plerros/Haptic-Bracelet/freecad/auxiliary/auxiliary.FCStd

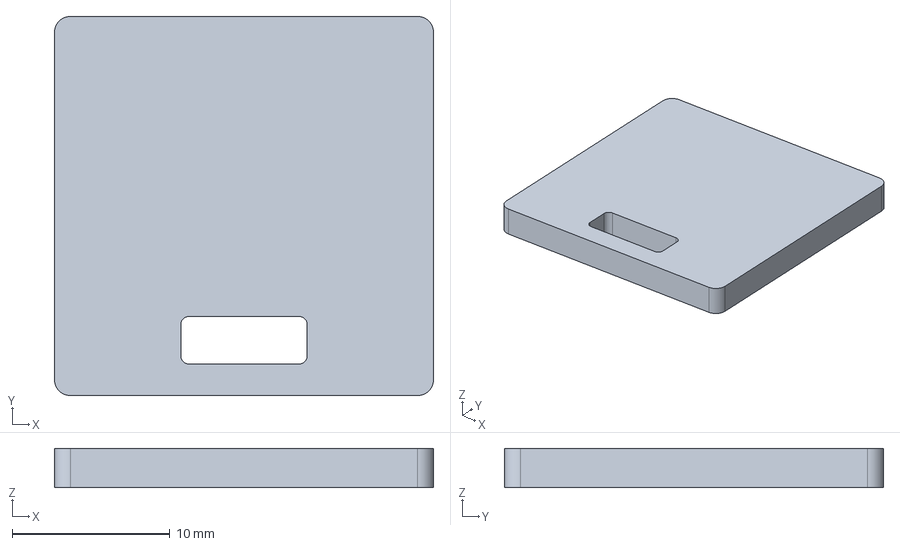
[picture p1: CAD file, 2025-09-05]
freecad/auxiliary/auxiliary.FCStd
24.0 x 24.0 x 2.50 mm
