plerros/Haptic-Bracelet/kicad/haptic-bracelet/haptic-bracelet.step

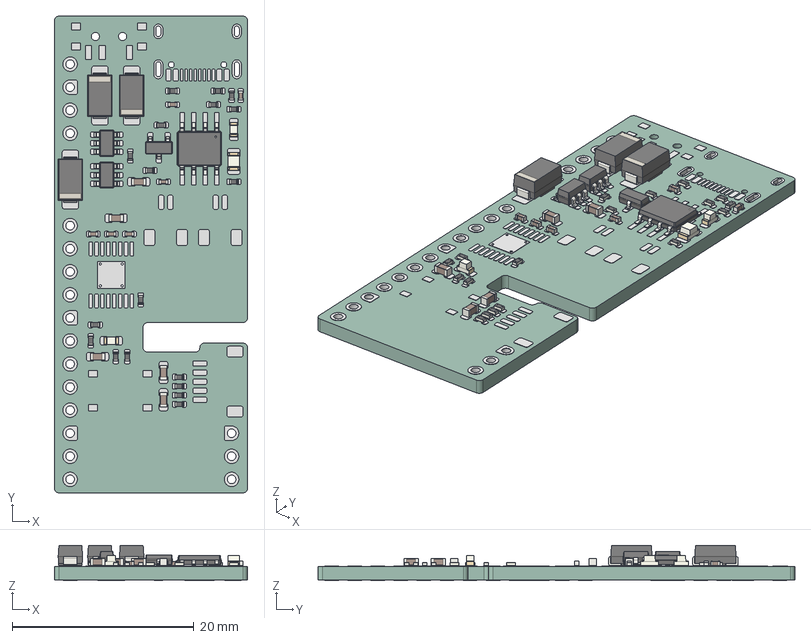
[picture p2: CAD file, 2025-09-05]
kicad/haptic-bracelet/haptic-bracelet.step
21.3 x 52.5 x 3.86 mm
SOT-23-6 x 2
R_0402_1005Metric x 18
C_0402_1005Metric x 6
C_0603_1608Metric x 5
D_SMA x 3
LED_0805_2012Metric
LED_0603_1608Metric x 2
SOT-23
Texas_HTSOP-8-1EP_3.9x4.9mm_P1.27mm_EP2.85x4.9mm_Mask2.4x3.1mm_ ThermalVias
haptic-bracelet_pad
haptic-bracelet_PCB
