plerros/Haptic-Bracelet/kicad/auxiliary/auxiliary.kicad_pcb

## KiCad design kicad/auxiliary/auxiliary.kicad_pcb (2025-09-05)

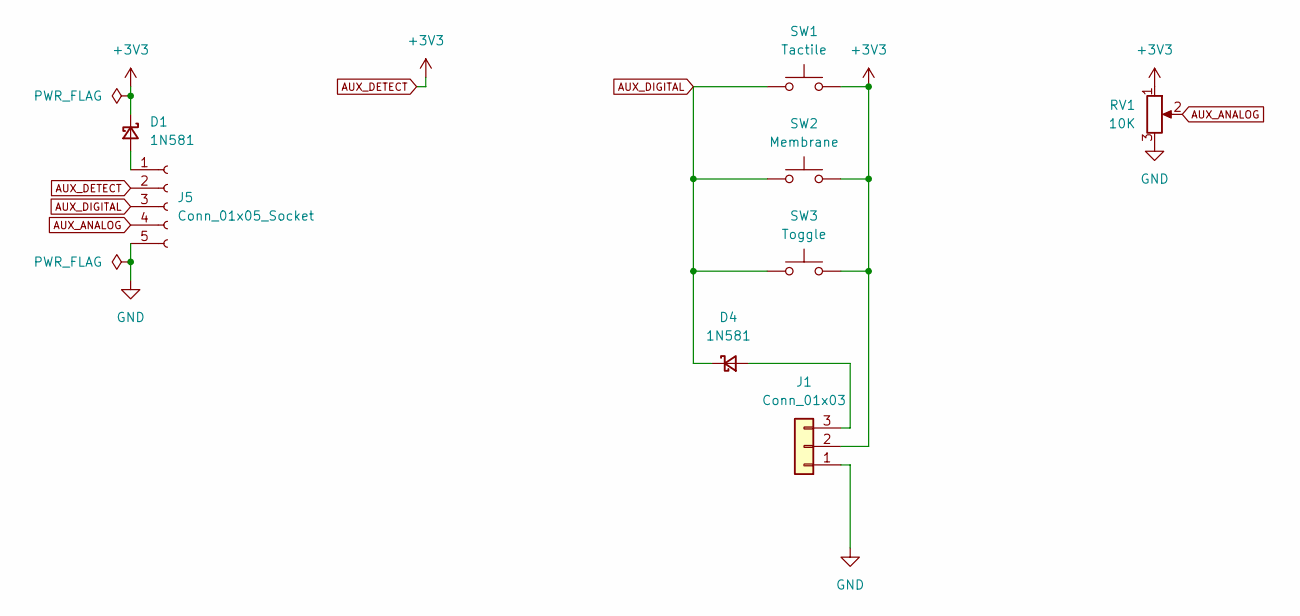
[picture p3: schematic auxiliary.kicad_sch]

Parts:
D1, D4: 1N581; D_A-405_P10.16mm_Horizontal
J1: Conn_01x03; PCB
J5: Conn_01x05_Socket; JST_PH_S5B-PH-K_1x05_P2.00mm_Horizontal
RV1: 10K; Potentiometer_Piher_PC-16_Single_Horizontal
SW1: Tactile; SW_PUSH_6mm
SW2: Membrane; SW_PUSH_8.5mm
SW3: Toggle; SW_Push_2P2T_Toggle_CK_PVA2OAH5xxxxxxV2

Connections:
AUX_ANALOG: J5.4, RV1.2
AUX_DETECT: D1.1 (K), J1.2, J5.2, RV1.1, SW1.2, SW2.2, SW3.2
AUX_DIGITAL: D4.1 (K), J5.3, SW1.1, SW2.1, SW3.1
GND: J1.1, J5.5, RV1.3
unnamed: D1.2 (A), J5.1
unnamed: D4.2 (A), J1.3

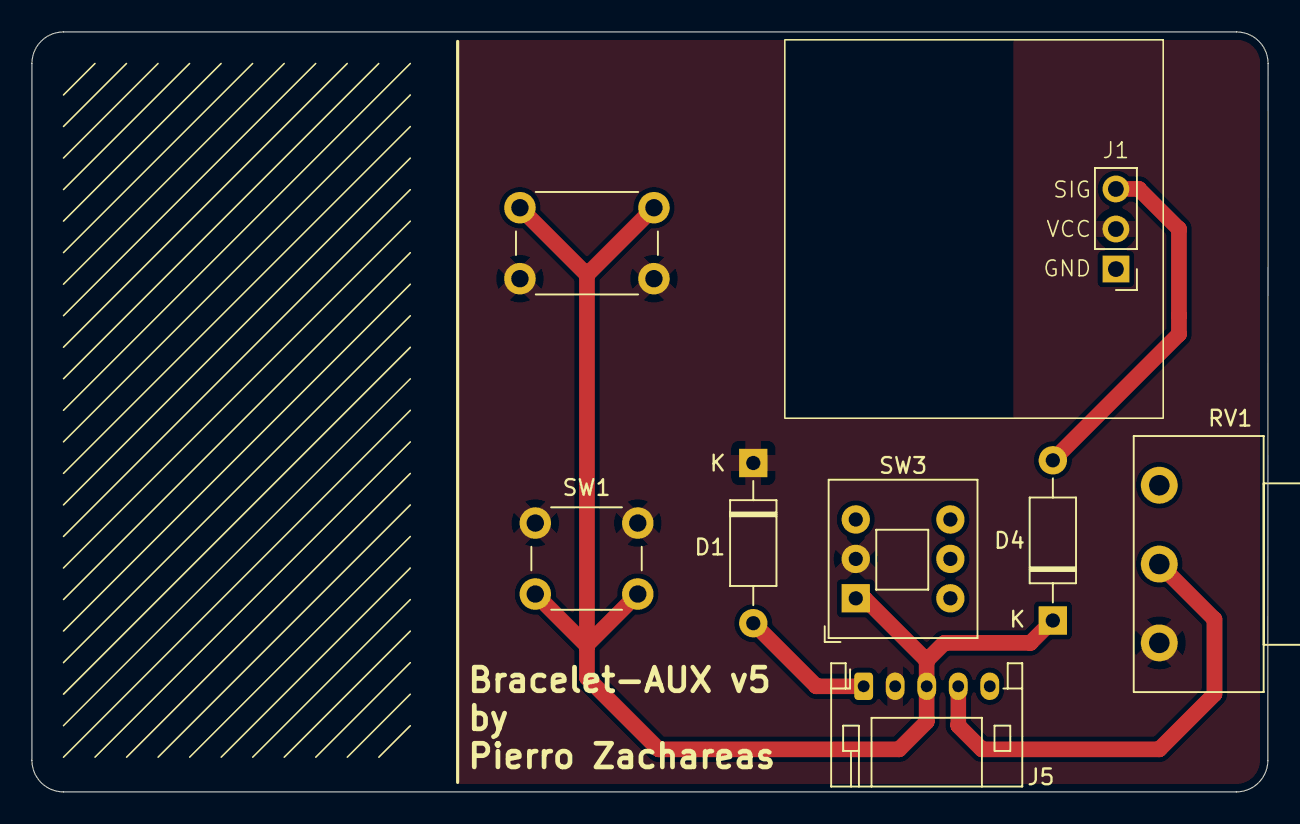
[picture p4: board auxiliary.kicad_pcb from above]

Board: 2 copper layers, 78.4 x 48.2 mm, 8 parts (0 on the bottom side), 6 nets.
