plerros/Haptic-Bracelet/kicad/haptic-bracelet/haptic-bracelet.kicad_pcb

## KiCad design kicad/haptic-bracelet/haptic-bracelet.kicad_pcb (2025-09-05)

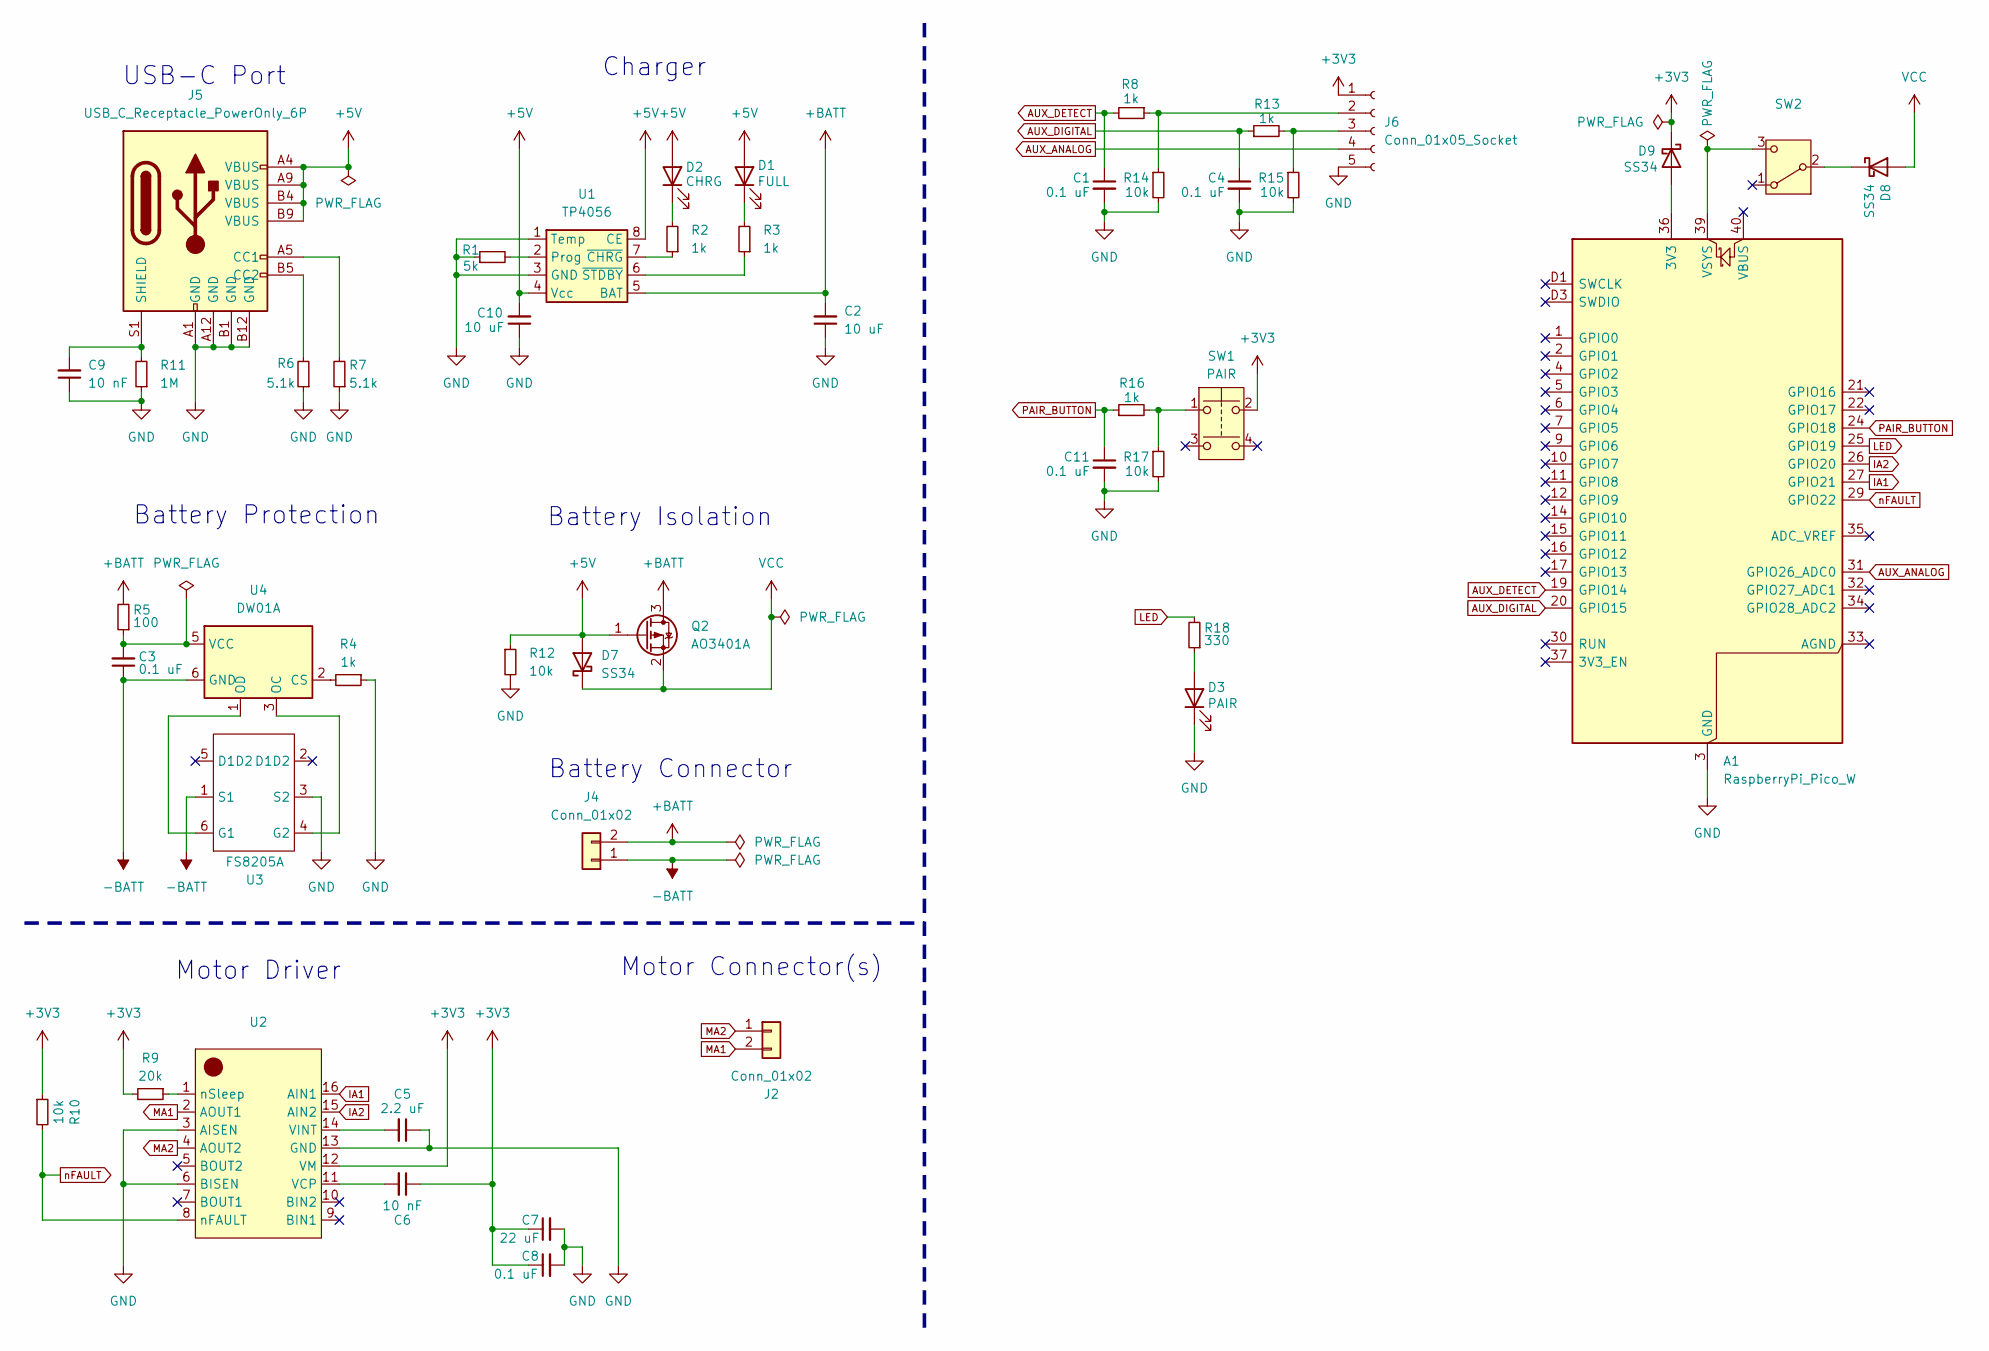
[picture p5: schematic haptic-bracelet.kicad_sch]

Parts:
A1: RaspberryPi_Pico_W; RaspberryPi_Pico_Common_THT
C1, C3, C4, C8, C11: 0.1 uF; C_0603_1608Metric; LCSC C1525
C2, C10: 10 uF; C_0402_1005Metric; LCSC C15525
C5: 2.2 uF; C_0402_1005Metric; LCSC C12530
C6, C9: 10 nF; C_0402_1005Metric; LCSC C15195
C7: 22 uF; C_0402_1005Metric; LCSC C415703
D1: FULL; LED_0805_2012Metric; LCSC C5569446
D2: CHRG; LED_0603_1608Metric; LCSC C5357909
D3: PAIR; LED_0603_1608Metric; LCSC C193191
D7, D8, D9: SS34; D_SMA; LCSC C8678
J2, J4: Conn_01x02; JST_SH_SM02B-SRSS-TB_1x02-1MP_P1.00mm_Horizontal; LCSC C160402
J5: USB_C_Receptacle_PowerOnly_6P; USB_C_Receptacle_HCTL_HC-TYPE-C-16P-01A; LCSC C2765186
J6: Conn_01x05_Socket; JST_SH_SM05B-SRSS-TB_1x05-1MP_P1.00mm_Horizontal; LCSC C3029344
Q2: AO3401A; SOT-23; LCSC C15127
R1: 5k; R_0402_1005Metric; LCSC C477765
R2, R3, R4, R8, R13, R16: 1k; R_0402_1005Metric; LCSC C11702
R5: 100; R_0402_1005Metric; LCSC C25076
R6, R7: 5.1k; R_0402_1005Metric; LCSC C25905
R9: 20k; R_0402_1005Metric; LCSC C25765
R10, R12, R14, R15, R17: 10k; R_0402_1005Metric; LCSC C25744
R11: 1M; R_0402_1005Metric; LCSC C26083
R18: 330; R_0402_1005Metric; LCSC C23138
SW1: PAIR; SW_Push_1P1T_XKB_TS-1187A; LCSC C318884
SW2: SW_SPDT; SW_SPDT_PCM12 vertical; LCSC C3008584
U1: TP4056; Texas_HTSOP-8-1EP_3.9x4.9mm_P1.27mm_EP2.95x4.9mm_Mask2.4x3.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; LCSC C7473158
U2: TSSOP-16-1EP_4.4x5mm_P0.65mm_EP3x3mm_ThermalVias; LCSC C128666
U3: FS8205A; SOT-23-6; LCSC C908265
U4: DW01A; SOT-23-6; LCSC C2927799

Connections:
+3V3: C6.1, C7.1, C8.1, D9.1 (K), J6.1, R9.2, R10.1, SW1.2, U2.12 (VM)
+5V: C10.2, D1.2 (A), D2.2 (A), D7.2 (A), J5.A4 (VBUS), J5.A9 (VBUS), J5.B4 (VBUS), J5.B9 (VBUS), Q2.1 (G), R12.1, U1.4 (Vcc), U1.8 (CE)
+BATT: C2.2, J4.2, Q2.3 (D), R5.2, U1.5 (BAT)
-BATT: C3.1, J4.1, U3.1 (S1), U4.6 (GND)
AUX_ANALOG: A1.31 (GPIO26_ADC0), J6.4
AUX_DETECT: A1.19 (GPIO14), C1.1, R8.2
AUX_DIGITAL: A1.20 (GPIO15), C4.1, R13.1
GND: A1.3 (GND), A1.8 (GND), A1.13 (GND), A1.18 (GND), A1.23 (GND), A1.28 (GND), A1.38 (GND), A1.D2 (GND), C1.2, C2.1, C4.2, C5.1, C7.2, C8.2, C9.1, C10.1, C11.2, D3.1 (K), J5.A1 (GND), J5.A12 (GND), J5.B1 (GND), J5.B12 (GND), J6.5, R1.1, R4.1, R6.1, R7.1, R11.1, R12.2, R14.2, R15.2, R17.2, U1.1 (Temp), U1.3 (GND), U2.3 (AISEN), U2.6 (BISEN), U2.13 (GND), U3.3 (S2)
IA1: A1.27 (GPIO21), U2.16 (AIN1)
IA2: A1.26 (GPIO20), U2.15 (AIN2)
LED: A1.25 (GPIO19), R18.2
MA1: J2.2, U2.2 (AOUT1)
MA2: J2.1, U2.4 (AOUT2)
unnamed: A1.36 (3V3), D9.2 (A)
unnamed: A1.39 (VSYS), SW2.3 (C)
unnamed: D1.1 (K), R3.2
unnamed: D2.1 (K), R2.2
unnamed: D3.2 (A), R18.1
unnamed: D8.1 (K), SW2.2 (B)
unnamed: J5.A5 (CC1), R7.2
unnamed: J5.B5 (CC2), R6.2
unnamed: C9.2, J5.S1 (SHIELD), R11.2
unnamed: J6.2, R8.1, R14.1
unnamed: J6.3, R13.2, R15.1
unnamed: R16.2, R17.1, SW1.1
unnamed: R1.2, U1.2 (Prog)
unnamed: R2.1, U1.7 (~CHRG)
unnamed: R3.1, U1.6 (~STDBY)
unnamed: C6.2, U2.11 (VCP)
unnamed: C5.2, U2.14 (VINT)
unnamed: R9.1, U2.1 (nSleep)
unnamed: U3.6 (G1), U4.1 (OD)
unnamed: U3.4 (G2), U4.3 (OC)
unnamed: R4.2, U4.2 (CS)
unnamed: C3.2, R5.1, U4.5 (VCC)
PAIR_BUTTON: A1.24 (GPIO18), C11.1, R16.1
VCC: D7.1 (K), D8.2 (A), Q2.2 (S)
nFAULT: A1.29 (GPIO22), R10.2, U2.8 (nFAULT)

Notes on the sheet:
USB-C Port
Charger
Battery Protection
Motor Driver
Battery Connector
Motor Connector(s)
Battery Isolation

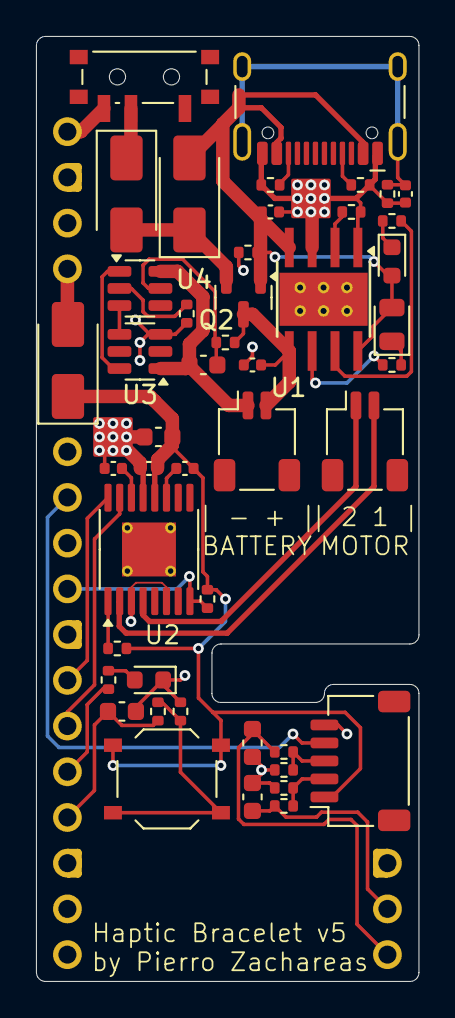
[picture p6: board haptic-bracelet.kicad_pcb from above]

Board: 2 copper layers, 21.3 x 52.5 mm, 47 parts (1 on the bottom side), 38 nets.
