plerros/Haptic-Bracelet/firmware/src/analog/analog.c

/*
 * Copyright (c) 2025 Pierro Zachareas
 *
 * SPDX-License-Identifier: GPL-3.0-only
 */

#include <stdlib.h>
#include "hardware/adc.h"
#include "hardware/gpio.h"
#include "pico/stdlib.h"
#include "pico/malloc.h"

#include "config.h"
#include "config_adv.h"
#include "analog.h"

enum analog_prev {ap_low, ap_high, ap_size};

struct analog_t {
	uint pin;
	uint adc_id;

	volatile adc_t    _Atomic raw_values[ANALOG_AVERAGING_WINDOW];
	volatile size_t   _Atomic last_written;
	volatile uint32_t _Atomic avg_sum;

	volatile adc_t _Atomic prev[ap_size];

	volatile ms_t _Atomic activation1_time;
	bool           activation2_consumed;
	// External
};

static inline void analog_read(struct analog_t *ptr)
{
	adc_select_input(ptr->adc_id);
	adc_t value = adc_read();

	size_t i = ptr->last_written;
	size_t i_next = 0;
	if (i < ANALOG_AVERAGING_WINDOW - 1)
		i_next = i + 1;

	ptr->avg_sum -= ptr->raw_values[i_next];
	ptr->raw_values[i_next] = value;
	ptr->avg_sum += value;
	ptr->last_written = i_next;
}

static inline adc_t analog_avg_now(struct analog_t *ptr)
{
	return (ptr->avg_sum / ANALOG_AVERAGING_WINDOW);
}

static inline void analog_reset(struct analog_t *ptr)
{
	adc_t now = analog_avg_now(ptr);

	ptr->prev[ap_low]  = now;
	ptr->prev[ap_high] = now;
}

void analog_new(struct analog_t **ptr, uint pin, uint adc_id)
{
	// TODO error check ptr
	struct analog_t *new = malloc(sizeof(struct analog_t));
	if (new == NULL) {
		// error
	}

	new->pin = pin;
	adc_gpio_init(new->pin);

	new->adc_id = adc_id;

	new->avg_sum = 0;
	for (size_t i = 0; i < ANALOG_AVERAGING_WINDOW; i++) {
		new->raw_values[i] = 0;
		new->last_written = i;
	}

	for (size_t i = 0; i < ANALOG_AVERAGING_WINDOW; i++)
		analog_read(new);

	analog_reset(new);

	new->activation1_time     = 0;
	new->activation2_consumed = true;
	*ptr = new;
}

void analog_free(struct analog_t *ptr)
{
	free(ptr);
}

void analog_update(struct analog_t *ptr)
{
	analog_read(ptr);
	adc_t now = analog_avg_now(ptr);

	if (now < ptr->prev[ap_low])
		ptr->prev[ap_low] = now;

	if (now > ptr->prev[ap_high])
		ptr->prev[ap_high] = now;
}

bool analog_active(struct analog_t *ptr, adc_t threshold_percent)
{
	// Cap the input
	if (threshold_percent > 100)
		threshold_percent = 100;

	adc_t current = ptr->prev[ap_high] - ptr->prev[ap_low];

	if ((current / ADC_PERCENT) < threshold_percent)
		return false;

	analog_reset(ptr);
	ptr->activation1_time = ms_now();

	return true;
}

bool analog_active2(struct analog_t *ptr, ms_t before)
{
	if (ptr->activation2_consumed == true)
		return false;

	if (ms_now() > ptr->activation1_time + before) {
		ptr->activation2_consumed = true;
		return true;
	}
	return false;
}
