plerros/Haptic-Bracelet/firmware/src/digital/digital.h

/*
 * Copyright (c) 2025 Pierro Zachareas
 *
 * SPDX-License-Identifier: GPL-3.0-only
 */

#ifndef HAPTIC_BRACELET_FIRMWARE_DIGITAL_H
#define HAPTIC_BRACELET_FIRMWARE_DIGITAL_H

#include "pico/stdlib.h"

#include "config_adv.h"

enum digital_io_types {low_is_false, low_is_true};

struct digital_t;

void digital_new(struct digital_t **ptr, uint pin, int type);
void digital_update(struct digital_t *ptr);

bool digital_now(struct digital_t *ptr);

/*
 * digital_trap:
 *
 * Normally false. True if signal was ever set to true.
 */
bool digital_trap(struct digital_t *ptr);

/*
 * digital_went_true:
 *
 * Is there a transition {false -> true} of this pin that I haven't consumed?
 */
bool digital_went_true(struct digital_t *ptr);

/*
 * digital_went_false:
 *
 * Is there a transition {true -> false} of this pin that I haven't consumed?
 */
bool digital_went_false(struct digital_t *ptr);

bool digital_held_true(struct digital_t *ptr, ms_t at_least);

#endif /* HAPTIC_BRACELET_FIRMWARE_DIGITAL_H */
