plerros/Haptic-Bracelet/(commit log)

2025-03-25 initial calibration & tests
2025-03-28 hardware updates on timer
    no need to manually call update()
2025-03-28 workaround to enable LTO
    - included nanoprintf library
    [config.h, main.c]
2025-04-08 led driver
2025-04-11 functional aux board
2025-04-16 reduce analog update
    added a sliding window that keeps previous analog values and takes the average, instead of making 64 reads on each update
    used to take 160-350 μs, now takes 8 μs
2025-04-16 even faster callback time
    store the sum and conditionally subtract the old value and add the new one
    reduces time from 8 μs to 5 μs
2025-04-16 vibrate when letting go of button
    [digital.c, digital.h, main.c, motor.c]
2025-04-16 don't interrupt an active pulse
2025-04-18 initial ble code
    It just does bluetooth le pairing.
    cy43 can't be compiled with -flto because of printf warnings
2025-04-18 haptic tuning
    - 2nd activation to analog potentiometer
    - feedback dampening in motor
2025-04-23 blink led on pair
2025-06-26 switch to bt classic + fixes
    - using rfcomm over bt classic
    - switched to atomic on some variables
    [analog.c, btstack_config.h, digital.c, led.c, main.c, motor.c]
2025-09-05 kicad files
    [BOM-auxiliary.csv, BOM-haptic-bracelet.csv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]
2025-09-05 freecad files
    [auxiliary.FCStd]
